Samuelogeno/Electronic-Bird-Deterrent-Project/Ochor_PPT_Project.pdf

# DESIGN OF AN ELECTRONIC BIRD

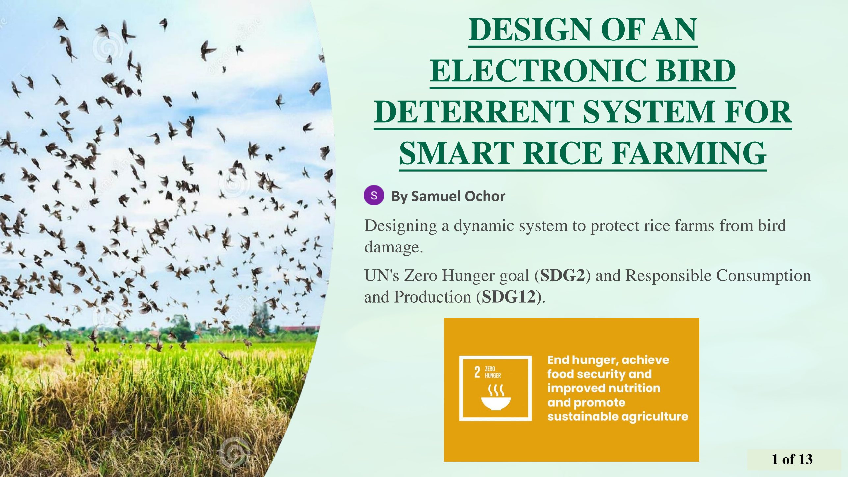
[picture p1: page 1]

# DETERRENT SYSTEM FOR SMART RICE FARMING

### Designing a dynamic system to protect rice farms from bird

damage.

### UN's Zero Hunger goal (SDG2) and Responsible Consumption

and Production (SDG12).

### By Samuel Ochor

### 1 of 13 (https://gamma.app/?utm_source=made-with-gamma)

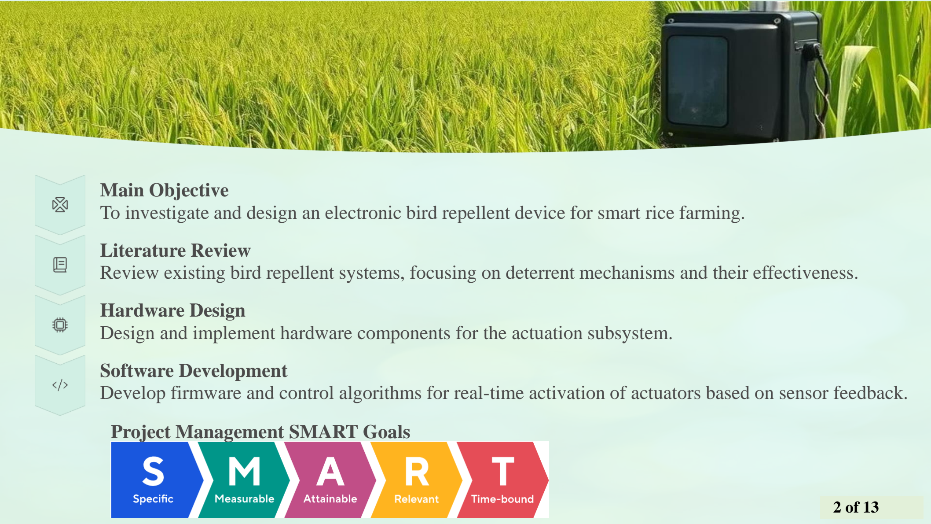
[picture p2: page 2]

### Main Objective

To investigate and design an electronic bird repellent device for smart rice farming.

### Literature Review

Review existing bird repellent systems, focusing on deterrent mechanisms and their effectiveness.

### Hardware Design

Design and implement hardware components for the actuation subsystem.

### Software Development

Develop firmware and control algorithms for real-time activation of actuators based on sensor feedback.

### Project Management SMART Goals

### 2 of 13 (https://gamma.app/?utm_source=made-with-gamma)

# BACKGROUND & PROBLEM

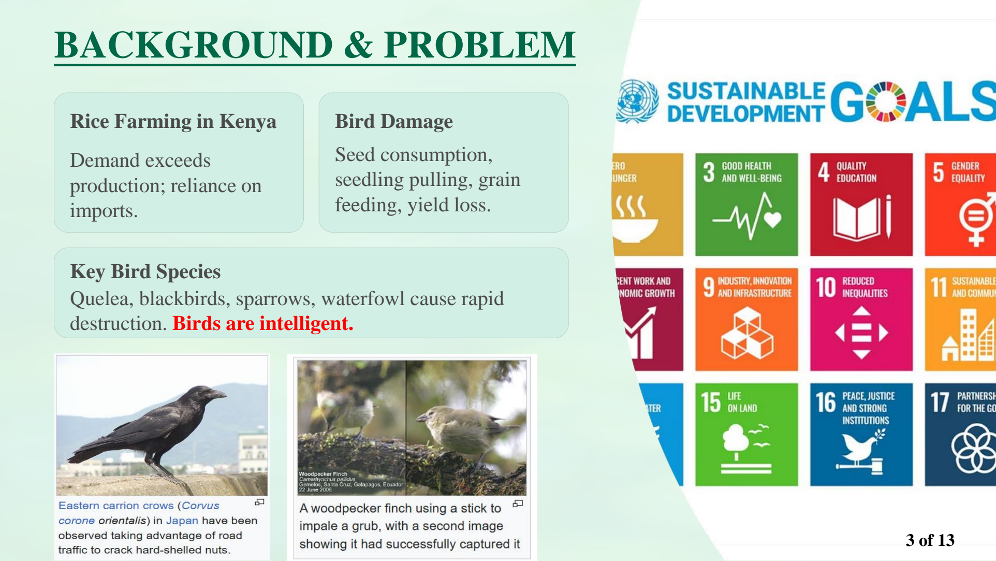
[picture p3: page 3]

### Rice Farming in Kenya

### Demand exceeds production; reliance on

imports.

### Bird Damage

Seed consumption,

### seedling pulling, grain

feeding, yield loss.

### Key Bird Species

### Quelea, blackbirds, sparrows, waterfowl cause rapid

destruction. Birds are intelligent.

### 3 of 13 (https://gamma.app/?utm_source=made-with-gamma)

# BIRD DETERRENT APPROACHES

## Chemical Repellents

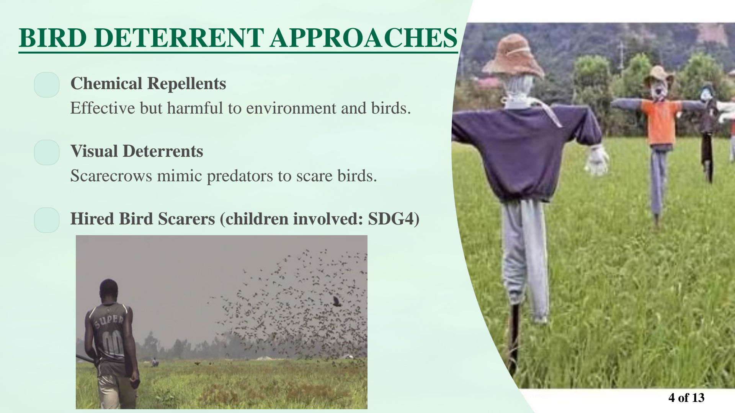
[picture p4: page 4]

Effective but harmful to environment and birds.

## Visual Deterrents

Scarecrows mimic predators to scare birds.

## Hired Bird Scarers (children involved: SDG4)

### 4 of 13 (https://gamma.app/?utm_source=made-with-gamma)

# ADVANCED DETERRENT DEVICES

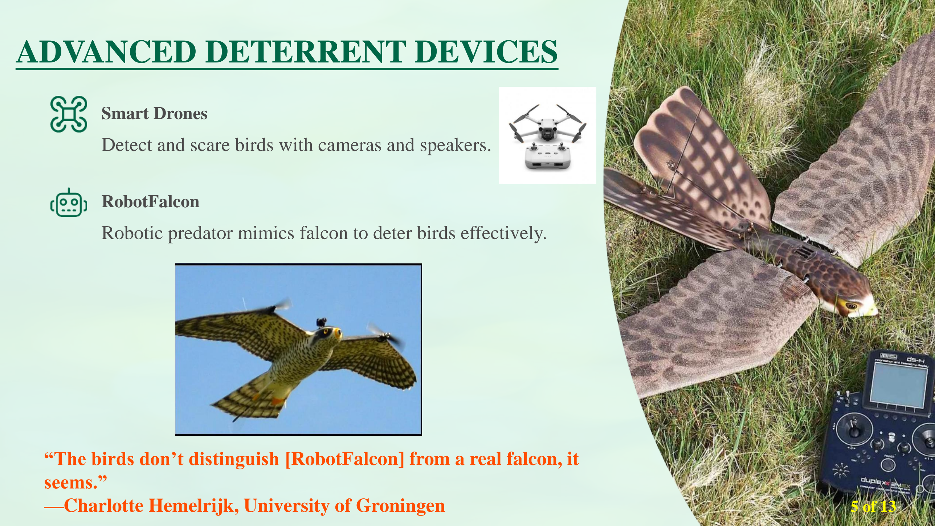
[picture p5: page 5]

Smart Drones
Detect and scare birds with cameras and speakers.

RobotFalcon
Robotic predator mimics falcon to deter birds effectively.

### “The birds don’t distinguish [RobotFalcon] from a real falcon, it seems.”

—Charlotte Hemelrijk, University of Groningen | 5 of 13 (https://gamma.app/?utm_source=made-with-gamma)

# TOP BIRD DETERRENT

# METHODS

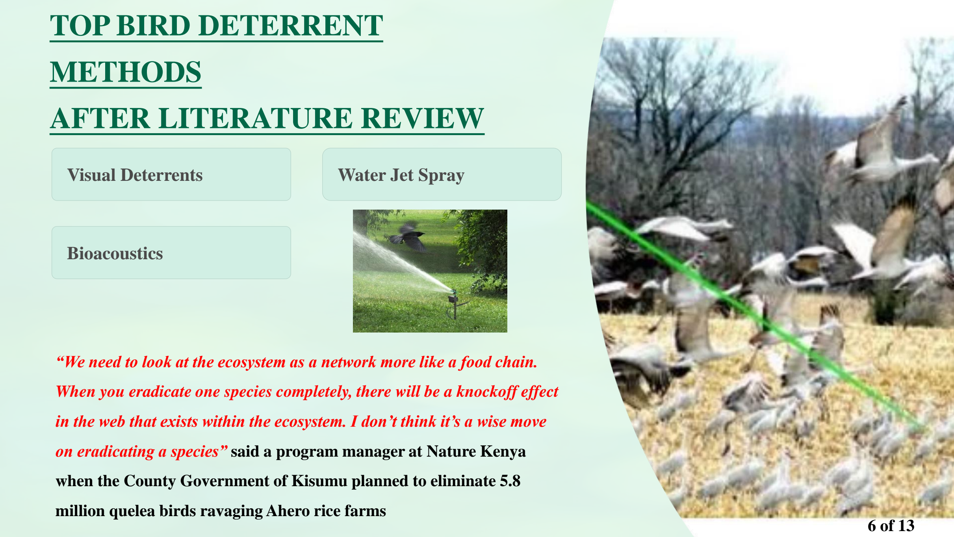
[picture p6: page 6]

# AFTER LITERATURE REVIEW

Visual Deterrents

Bioacoustics

Water Jet Spray

“We need to look at the ecosystem as a network more like a food chain.

When you eradicate one species completely, there will be a knockoff effect

in the web that exists within the ecosystem. I don’t think it’s a wise move

on eradicating a species” said a program manager at Nature Kenya

when the County Government of Kisumu planned to eliminate 5.8

million quelea birds ravaging Ahero rice farms

### 6 of 13 (https://gamma.app/?utm_source=made-with-gamma)

# METHODOLOGY

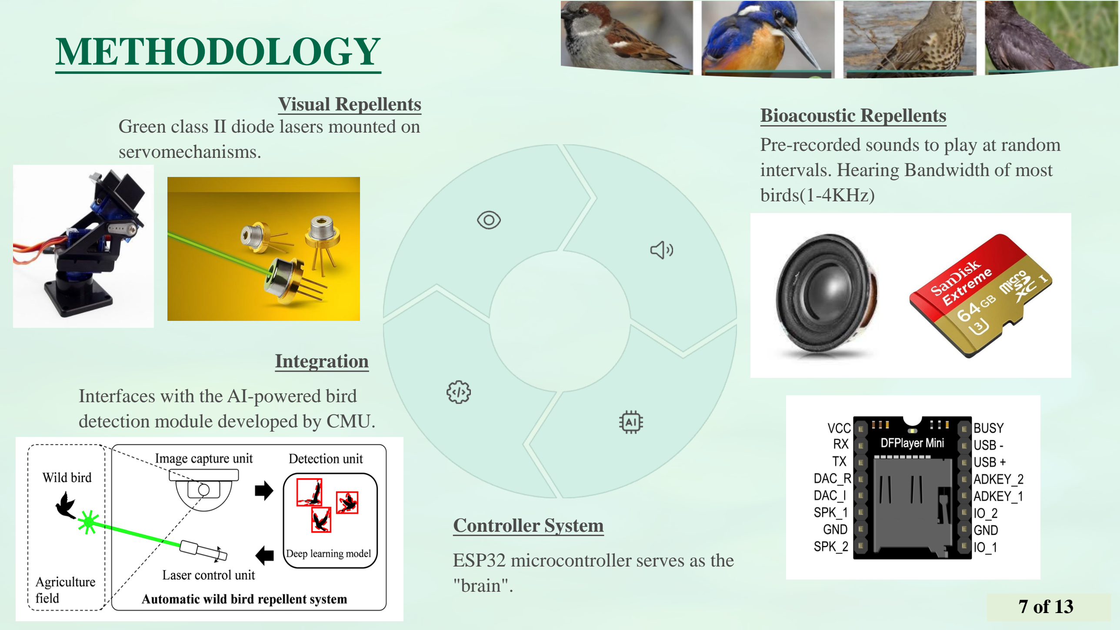
[picture p7: page 7]

Visual Repellents
Green class II diode lasers mounted on servomechanisms.

Bioacoustic Repellents
Pre-recorded sounds to play at random intervals. Hearing Bandwidth of most birds(1-4KHz)

Controller System

ESP32 microcontroller serves as the "brain".

Integration

Interfaces with the AI-powered bird detection module developed by CMU.

### 7 of 13 (https://gamma.app/?utm_source=made-with-gamma)

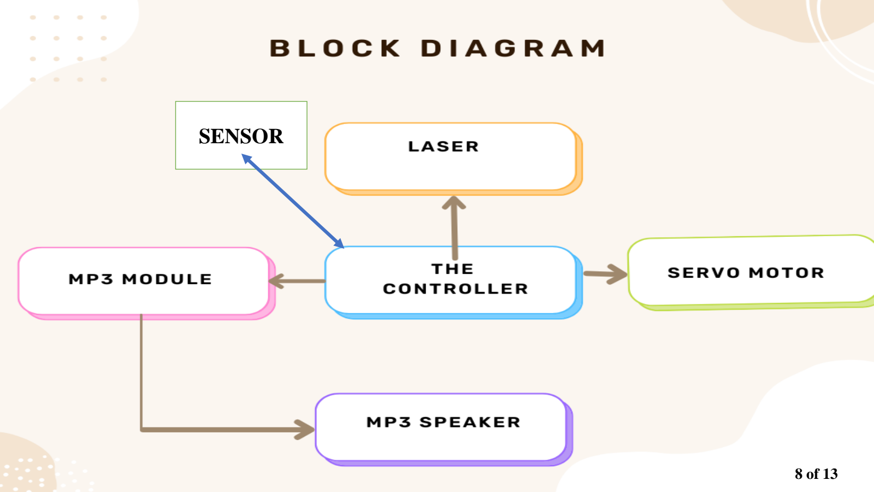
[picture p8: page 8]

### 8 of 13 (https://gamma.app/?utm_source=made-with-gamma)

## SENSOR

# HARDWARE IMPLEMENTATION

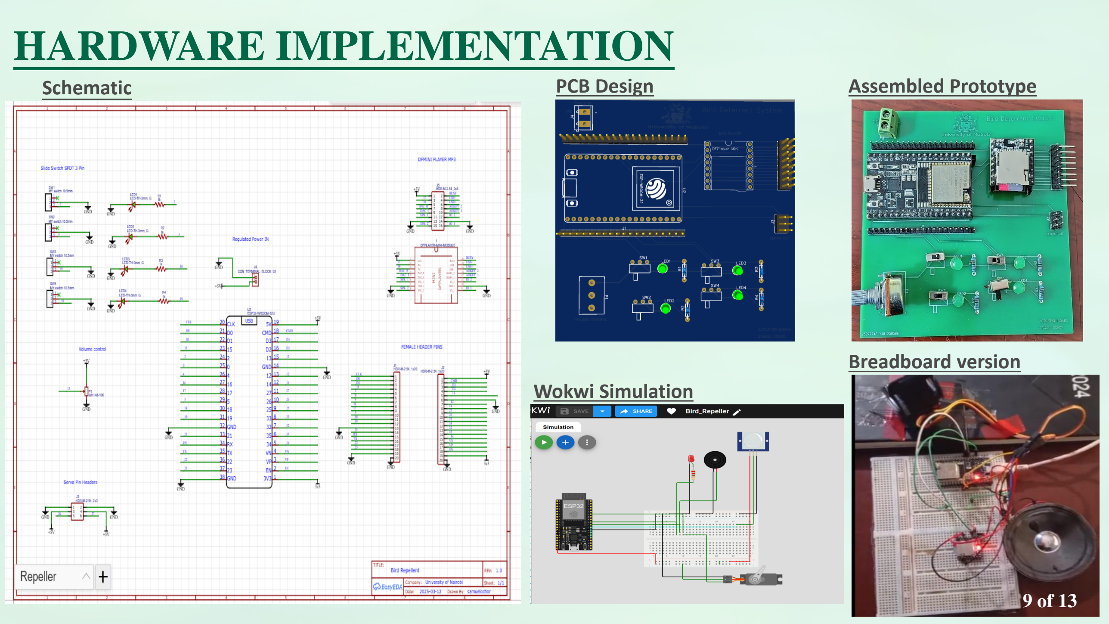
[picture p9: page 9]

Schematic | PCB Design | Assembled Prototype

### Wokwi Simulation

### Breadboard version

### 9 of 13 (https://gamma.app/?utm_source=made-with-gamma)

# SOFTWARE IMPLEMENTATION

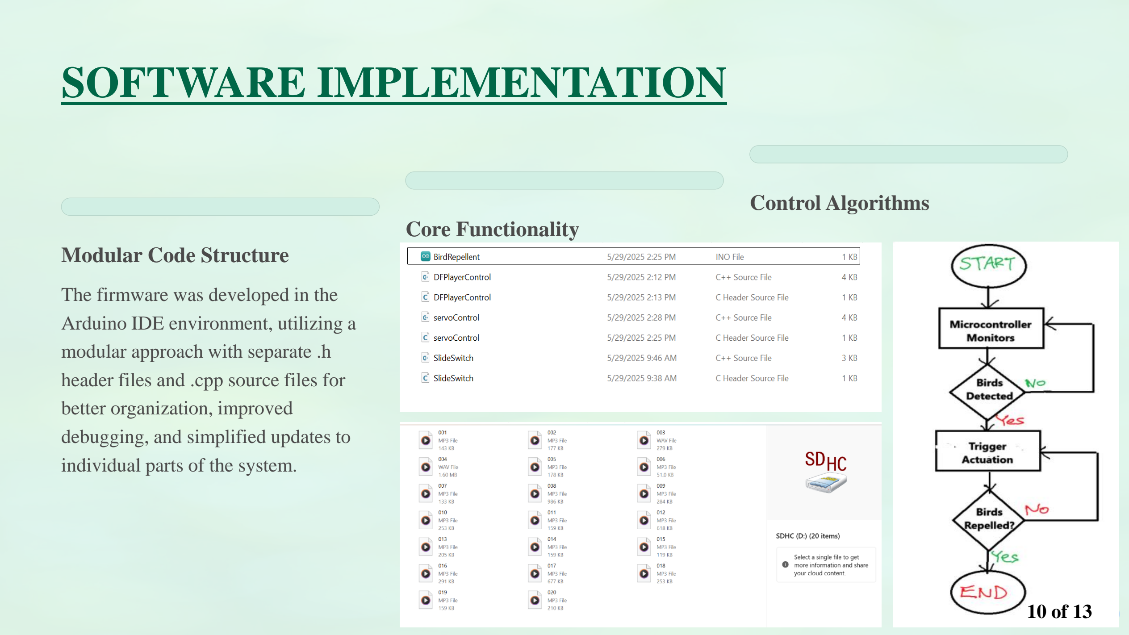
[picture p10: page 10]

Modular Code Structure

The firmware was developed in the Arduino IDE environment, utilizing a modular approach with separate .h header files and .cpp source files for better organization, improved debugging, and simplified updates to individual parts of the system.

Core Functionality

Control Algorithms

### 10 of 13 (https://gamma.app/?utm_source=made-with-gamma)

# RESULTS & EFFECTIVENESS

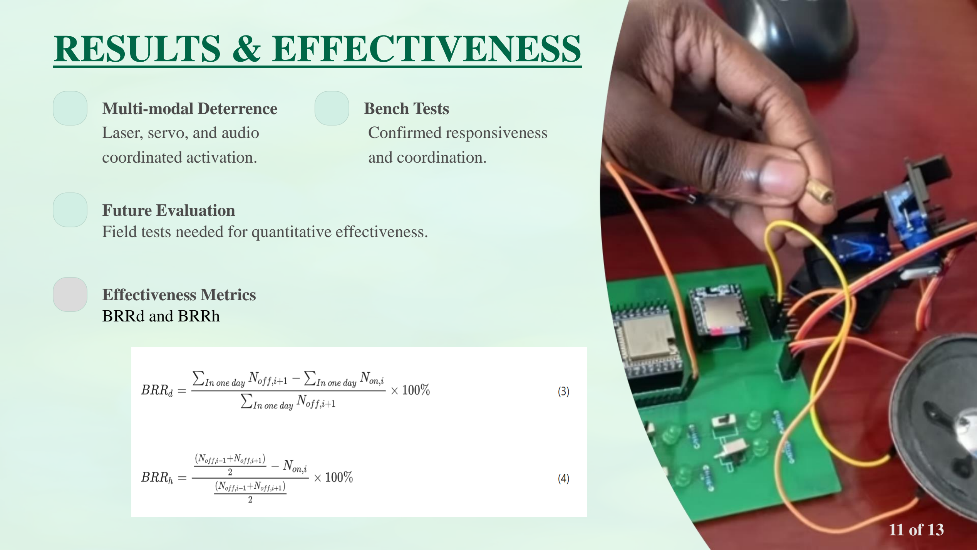
[picture p11: page 11]

Multi-modal Deterrence
Laser, servo, and audio
coordinated activation.

Bench Tests
Confirmed responsiveness
and coordination.

Future Evaluation
Field tests needed for quantitative effectiveness.

Effectiveness Metrics
BRRd and BRRh

### 11 of 13 (https://gamma.app/?utm_source=made-with-gamma)

# RECOMMENDATIONS

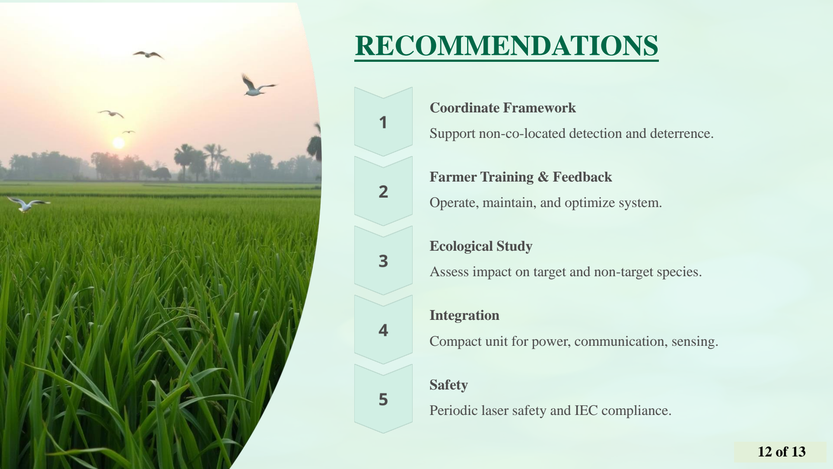
[picture p12: page 12]

Coordinate Framework

Support non-co-located detection and deterrence.

Farmer Training & Feedback

Operate, maintain, and optimize system.

Ecological Study

Assess impact on target and non-target species.

Integration

Compact unit for power, communication, sensing.

Safety

Periodic laser safety and IEC compliance.

### 12 of 13 (https://gamma.app/?utm_source=made-with-gamma)

# THANK

YOU.

### 13 of 13 (https://gamma.app/?utm_source=made-with-gamma)
